jaosber/esp32-hydrogen-monitor/assets/images/img02.png

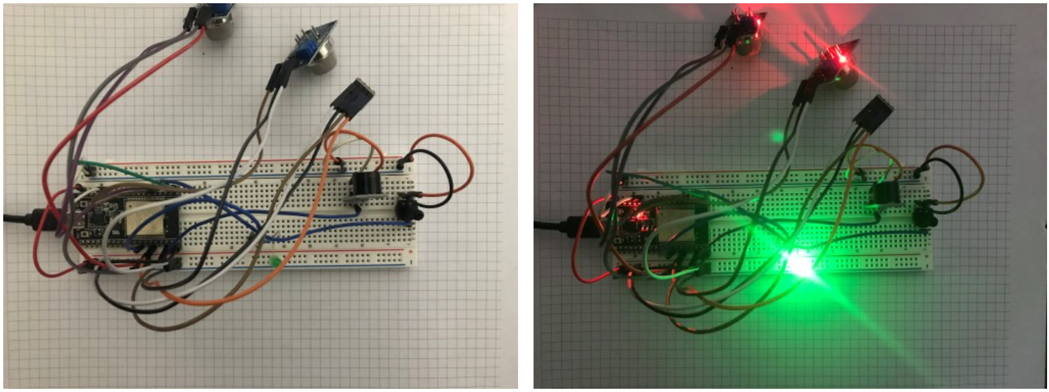
assets/images/img02.png
