jaosber/esp32-hydrogen-monitor/assets/images/img04.png

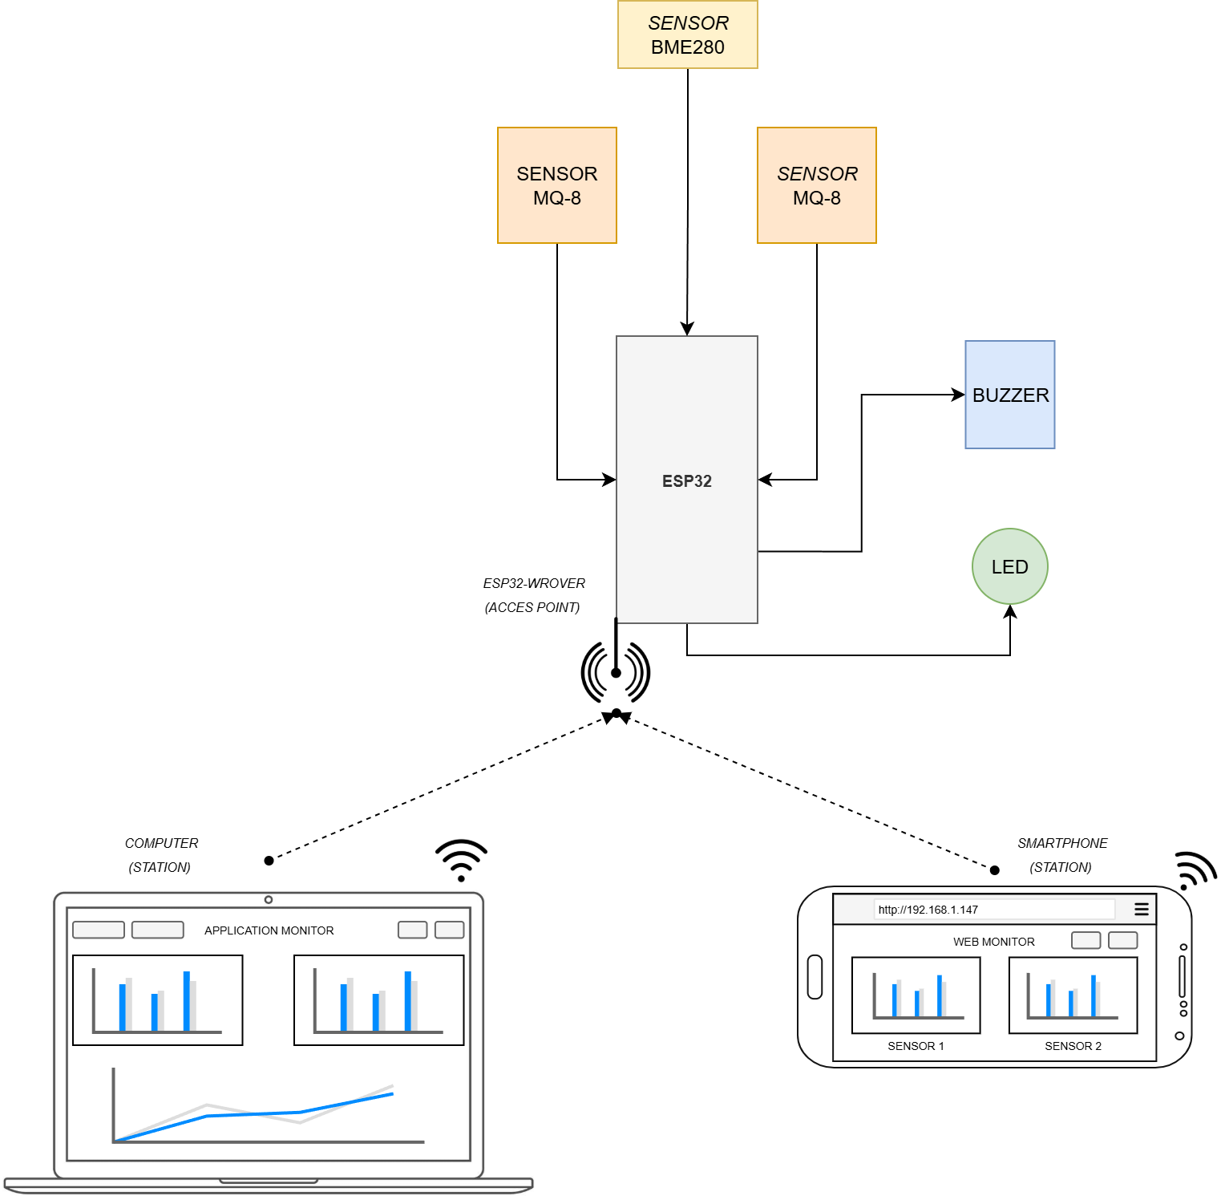
assets/images/img04.png
