jaosber/esp32-hydrogen-monitor/assets/images/img05.png

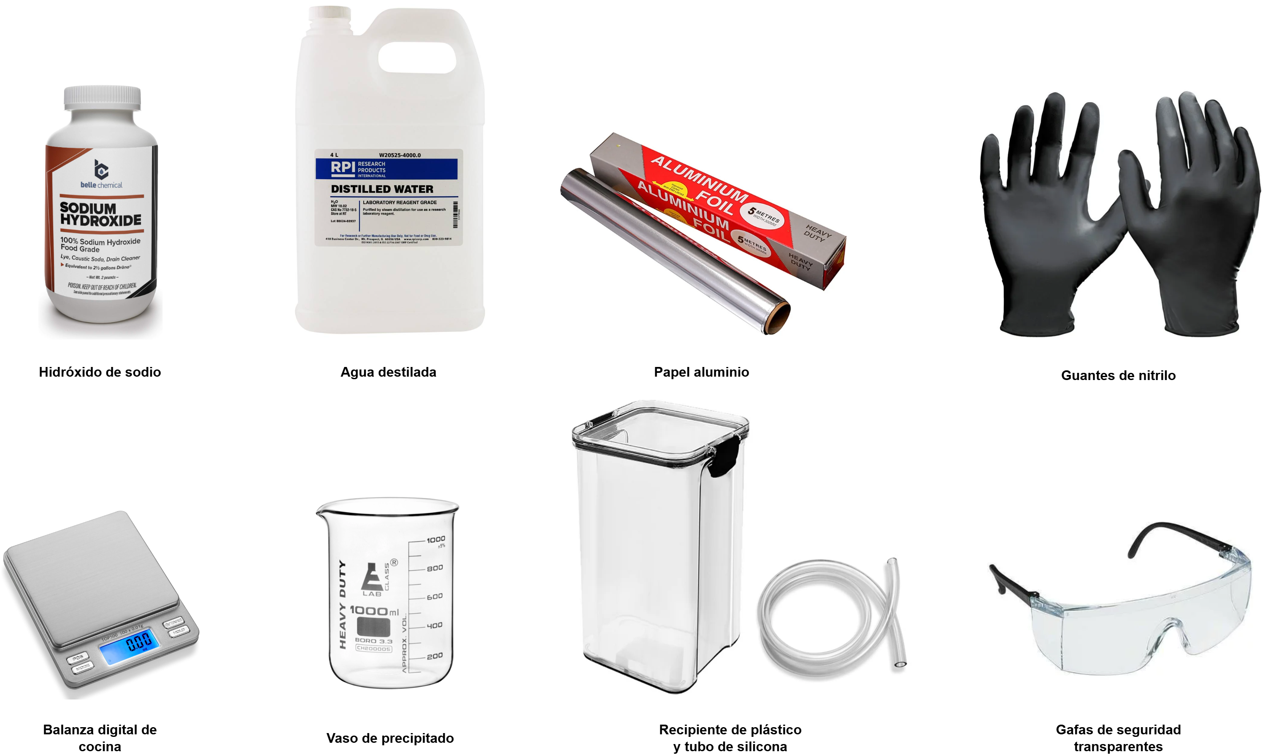
assets/images/img05.png
