jaosber/esp32-hydrogen-monitor/assets/video/h2-test-detection.gif

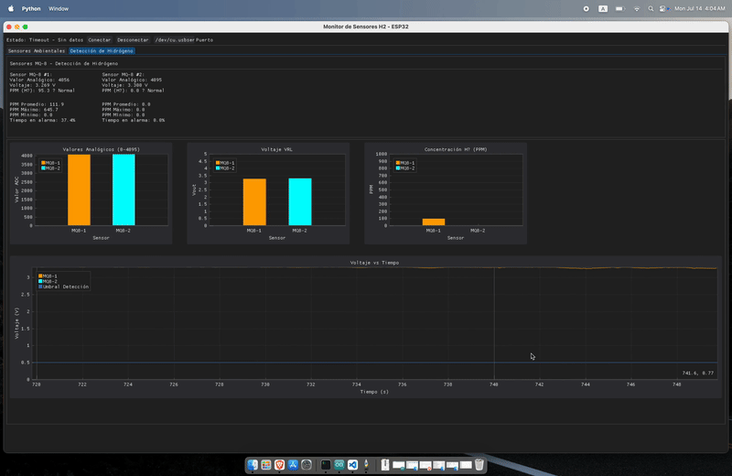
assets/video/h2-test-detection.gif
